lis-marcel/FoxSky.TractorVCU/doc/TractorVCU_v1.0_BOM.xlsx

TractorVCU v1.0 – lista elementów (BOM)
Źródło: schematy Tractor2000.SchDoc, MCU.SchDoc, LOAD_SWITCHES.SchDoc, POWER.SchDoc (10.06.2026)
Liczba płytek do złożenia: |  |  | 1
Legenda: żółte pole – wpisz liczbę płytek; niebieskie liczby – ilości wpisane ręcznie (reszta liczona z listy oznaczeń); „TAK” w kolumnie Weryfikacja – obudowa przyjęta jako typowa, bo PDF schematu nie zawiera footprintów – sprawdź z PCB przed zamówieniem.
Lp. | Oznaczenia | Ilość / płytkę | Wartość | Opis | Obudowa | Producent / przykładowy MPN | Montaż | Weryfikacja | Uwagi | Do zamówienia
Półprzewodniki i moduły
1 | U1 | 1 | NodeMCU-32 (30-pin) | Moduł ESP32 devkit (ESP32-WROOM-32) | Moduł, raster 2,54 mm | NodeMCU-32 / ESP32 DevKit V1 30-pin | THT |  | Wkładany w gniazda z poz. poniżej, nie lutowany | 1
2 | U1 – gniazda | 2 | Gniazdo żeńskie 1×15 | Listwa żeńska prosta, raster 2,54 mm, wys. ok. 8,5 mm | THT 1×15 | dowolna listwa żeńska 1×15 2,54 mm | THT |  | 2 szt. na płytkę (rząd 1–15 i 16–30). Sprawdź rozstaw rzędów footprintu z devkitem (22,86 vs 25,4 mm) | 2
3 | U2 | 1 | TPS562201DDCR | Przetwornica buck 4,5–17 V / 2 A | SOT-23-6 (DDC) | Texas Instruments TPS562201DDCR | SMD |  |  | 1
4 | L1 | 1 | 3,3 µH | Dławik mocy | 1008 (2520 metric) | Taiyo Yuden MAMK2520T3R3M | SMD |  |  | 1
5 | Q1, Q2, Q3, Q7, Q8, Q9, Q13, Q14, Q15, Q19, Q20, Q21 | 12 | AO3401 | P-MOSFET −30 V (klucz high-side) | SOT-23 | Alpha & Omega AO3401A | SMD |  |  | 12
6 | Q4, Q5, Q6, Q10, Q11, Q12, Q16, Q17, Q18, Q22, Q23, Q24, Q25 | 13 | BSS138 | N-MOSFET 50 V (sterowanie bramek, klucz buzzera) | SOT-23 | onsemi BSS138 | SMD |  |  | 13
7 | CR1 | 1 | SMBJ7.0A | Dioda TVS jednokierunkowa 7,0 V / 600 W | SMB (DO-214AA) | Littelfuse SMBJ7.0A lub odp. | SMD |  | Katoda na V_ESC | 1
8 | D1 | 1 | SS14 | Dioda Schottky 1 A / 40 V | SMA (DO-214AC) | SS14 (np. onsemi, Vishay) | SMD |  | Anoda V_ESC, katoda V_BUCK | 1
9 | D2 | 1 | 1N4148WT | Dioda impulsowa (zwrotna buzzera) | SOD-523 | 1N4148WT (np. Diodes Inc.) | SMD | TAK | Na wcześniejszych widokach PCB footprint D2 był większy niż SOD-523 – ujednolić element i footprint | 1
10 | D3, D4 | 2 | LED | Dioda LED sygnalizacyjna (kolor dowolny) | 0603 | dowolna LED 0603 | SMD |  | Debug LED, z R40/R41 330 Ω | 2
Kondensatory
11 | C3, C4 | 2 | 220 µF / 16 V | Kondensator polimerowy SMD (bulk V_ESC) | Ø6,3 mm lub wg footprintu | PCJ1C221MCL4GS | SMD | TAK | Dobrać MPN do średnicy footprintu na PCB | 2
12 | C13 | 1 | 47 µF / 16 V | MLCC X5R/X7R (hold-up V_BUCK) | 1210 | dowolny 47 µF 16 V X5R 1210 | SMD |  |  | 1
 | C5 | 1 | 10 µF / 16 V | MLCC X5R/X7R | 0603 | dowolny 10 µF 16–25 V X7R 1206 | SMD | TAK | C9–C12 przy grupach złączy, C5 wejście bucka | 1
13 | C9, C10, C11, C12 | 4 | 10 µF / 16 V | MLCC X5R/X7R | 0805 | dowolny 10 µF 16–25 V X7R 0805 | SMD | TAK | C9–C12 przy grupach złączy, C5 wejście bucka | 4
14 | C7, C8 | 2 | 22 µF / 10 V | MLCC X5R/X7R (wyjście bucka) | 0603 | dowolny 22 µF 10 V X5R 0603 | SMD | TAK |  | 2
15 | C14 | 1 | 1 µF / 16 V | MLCC X7R (zasilanie buzzera) | 0603 | dowolny 1 µF 16 V X7R 0603 | SMD | TAK |  | 1
16 | C1, C2, C6 | 3 | 100 nF / 50 V | MLCC X7R | 0402 | dowolny 100 nF 50 V X7R 0603 | SMD | TAK | C2 – bootstrap bucka (VBST–SW) | 3
Rezystory (1%)
17 | R1 | 1 | 1 kΩ | Rezystor szeregowy ESC_CONTROL | 0402 | dowolny 1 kΩ 1% 0603 | SMD | TAK |  | 1
18 | R3, R4, R5, R11, R12, R13, R19, R20, R21, R28, R29, R30 | 12 | 2,2 kΩ | Pull-up bramek AO3401 | 0402 | dowolny 2,2 kΩ 1% 0603 | SMD | TAK |  | 12
19 | R2, R6, R7, R8, R9, R10, R14, R15, R16, R17, R18, R22, R23, R24, R25, R26, R27, R31, R32, R33, R34, R35, R36, R38, R39 | 25 | 10 kΩ | Pull-downy bramek i wyjść, pull-down ESC, dzielnik FB | 0402 | dowolny 10 kΩ 1% 0603 | SMD | TAK | R38 – dolny rezystor dzielnika FB bucka | 25
20 | R37 | 1 | 33 kΩ | Górny rezystor dzielnika FB bucka | 0402 | dowolny 33 kΩ 1% 0603 | SMD | TAK | Vout = 0,768 V × (1 + 33k/10k) ≈ 3,30 V | 1
21 | R40, R41 | 2 | 330 Ω | Rezystory LED debug | 0603 | dowolny 330 Ω 1% 0603 | SMD | TAK |  | 2
Złącza
22 | J1, J2, J3, J4, J5, J6, J7, J8, J9, J10, J11, J12, J13 | 13 | HTSW-103-24-T-S | Listwa męska prosta 1×3, raster 2,54 mm | THT 1×3 | Samtec HTSW-103-24-T-S | THT |  | Alternatywnie zwykły goldpin 1×3 (lub listwa 1×40 cięta) | 13
23 | J14 | 1 | Goldpin 1×2 | Listwa męska prosta 1×2, raster 2,54 mm (buzzer) | THT 1×2 | dowolny goldpin 1×2 2,54 mm | THT |  |  | 1
Elementy PCB (nie zamawiane osobno)
24 | TP1, TP2, TP3, TP4, TP5, TP6 | 6 | Punkt testowy | Pad testowy | — | — | PCB | TAK | Jeśli footprint to pętla THT (np. Keystone 5012) – dopisz do zamówienia | —
25 | MH1, MH2, MH3, MH4 | 4 | Otwór M3 | Otwór montażowy metalizowany (GND) | — | — | PCB |  | Śruby/dystanse M3 – wg mocowania w modelu | —
Poza płytką (opcjonalnie)
26 | — | 1 | LD-BZEG-1203 | Buzzer elektromagnetyczny z generatorem 2–5 V, 30 mA | THT Ø12 mm | Loudity LD-BZEG-1203 | Poza płytką |  | Na kablu do J14, zachować polaryzację | 1
27 | — | 1 | Przewód z wtykiem 1×2 | Przewód z gniazdem żeńskim 2,54 mm do J14 | — | np. przewód Dupont F 1×2 | Poza płytką |  |  | 1
Podsumowanie (na 1 płytkę)
 | Elementy SMD | 87
 | Elementy THT (z gniazdami devkita) | 17
 | Razem do montażu na płytce | 104
