lis-marcel/FoxSky.TractorVCU/doc/FoxSky.TractorVCU.pdf

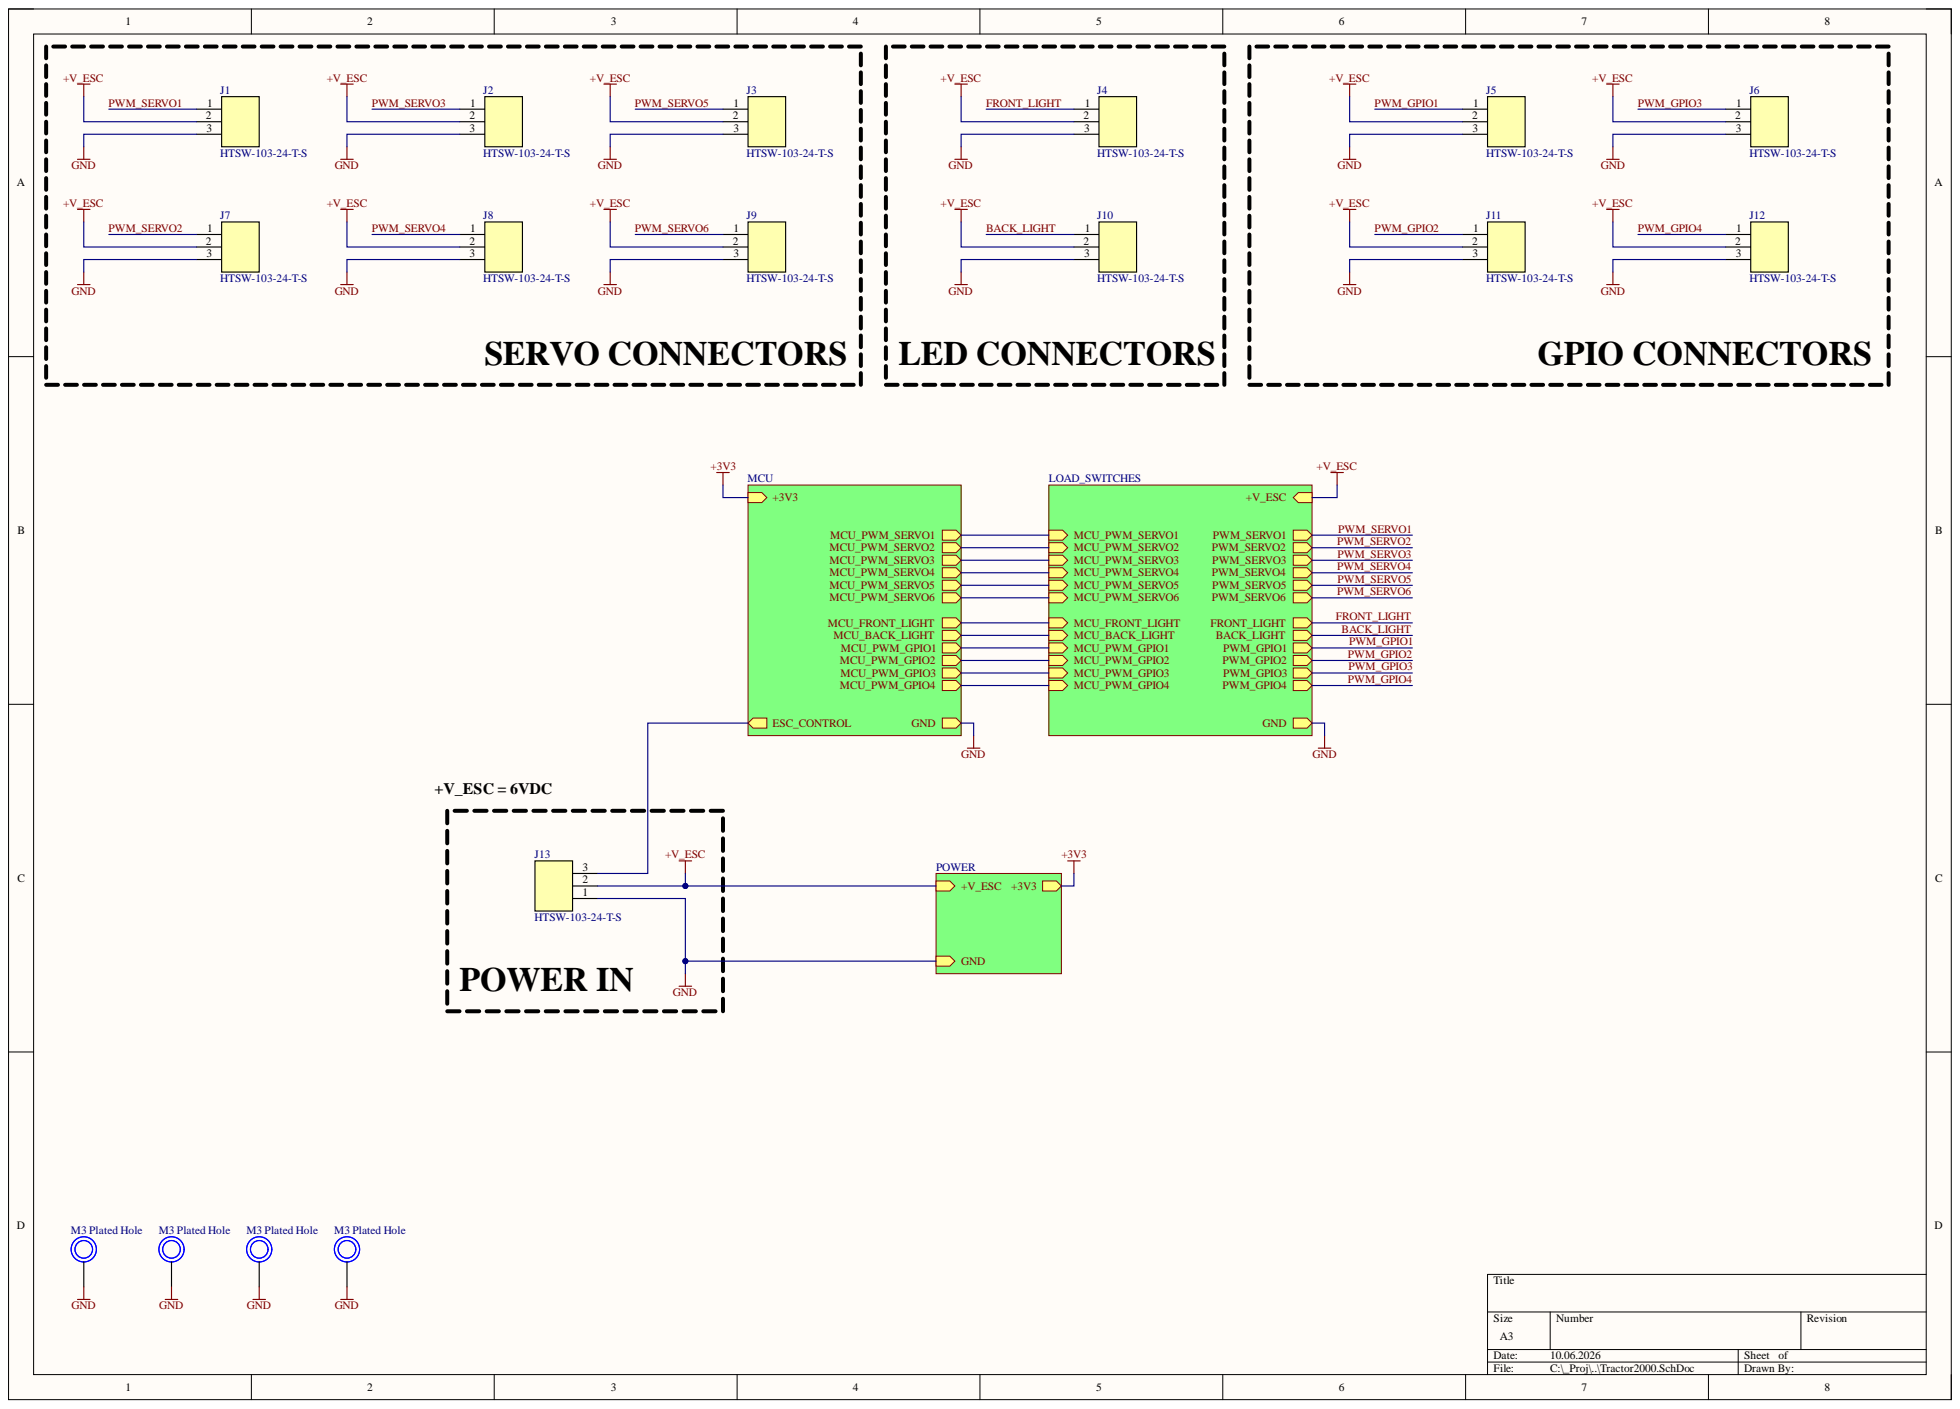
[picture p1: page 1]

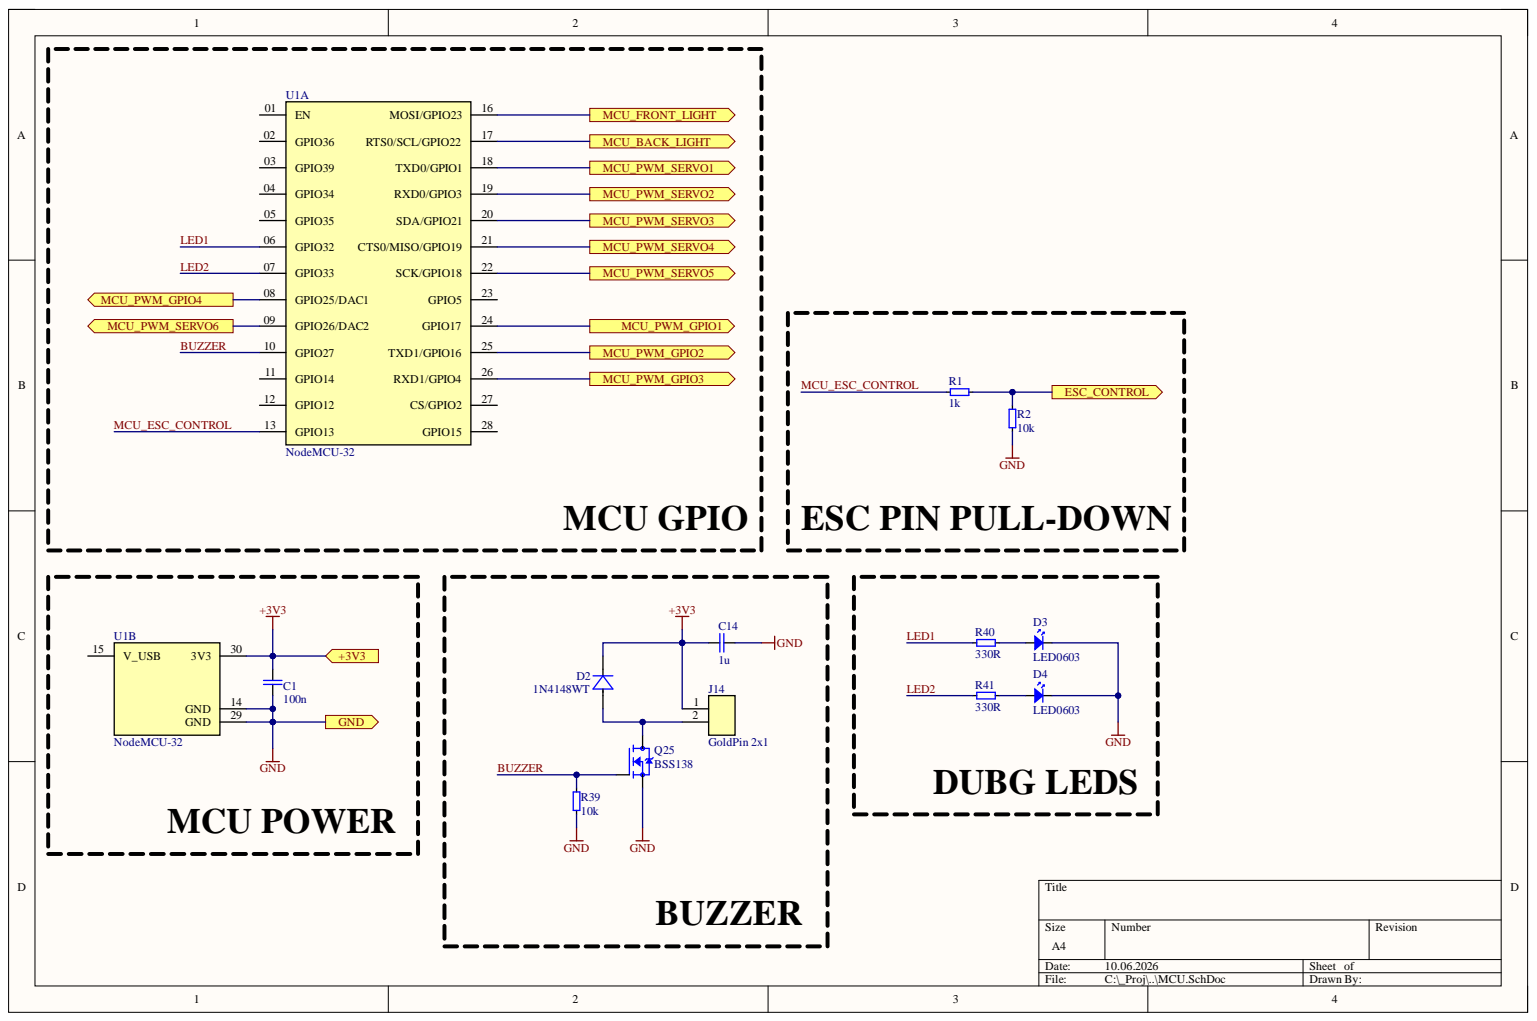
[picture p2: page 2]

ESC PIN PULL-DOWN

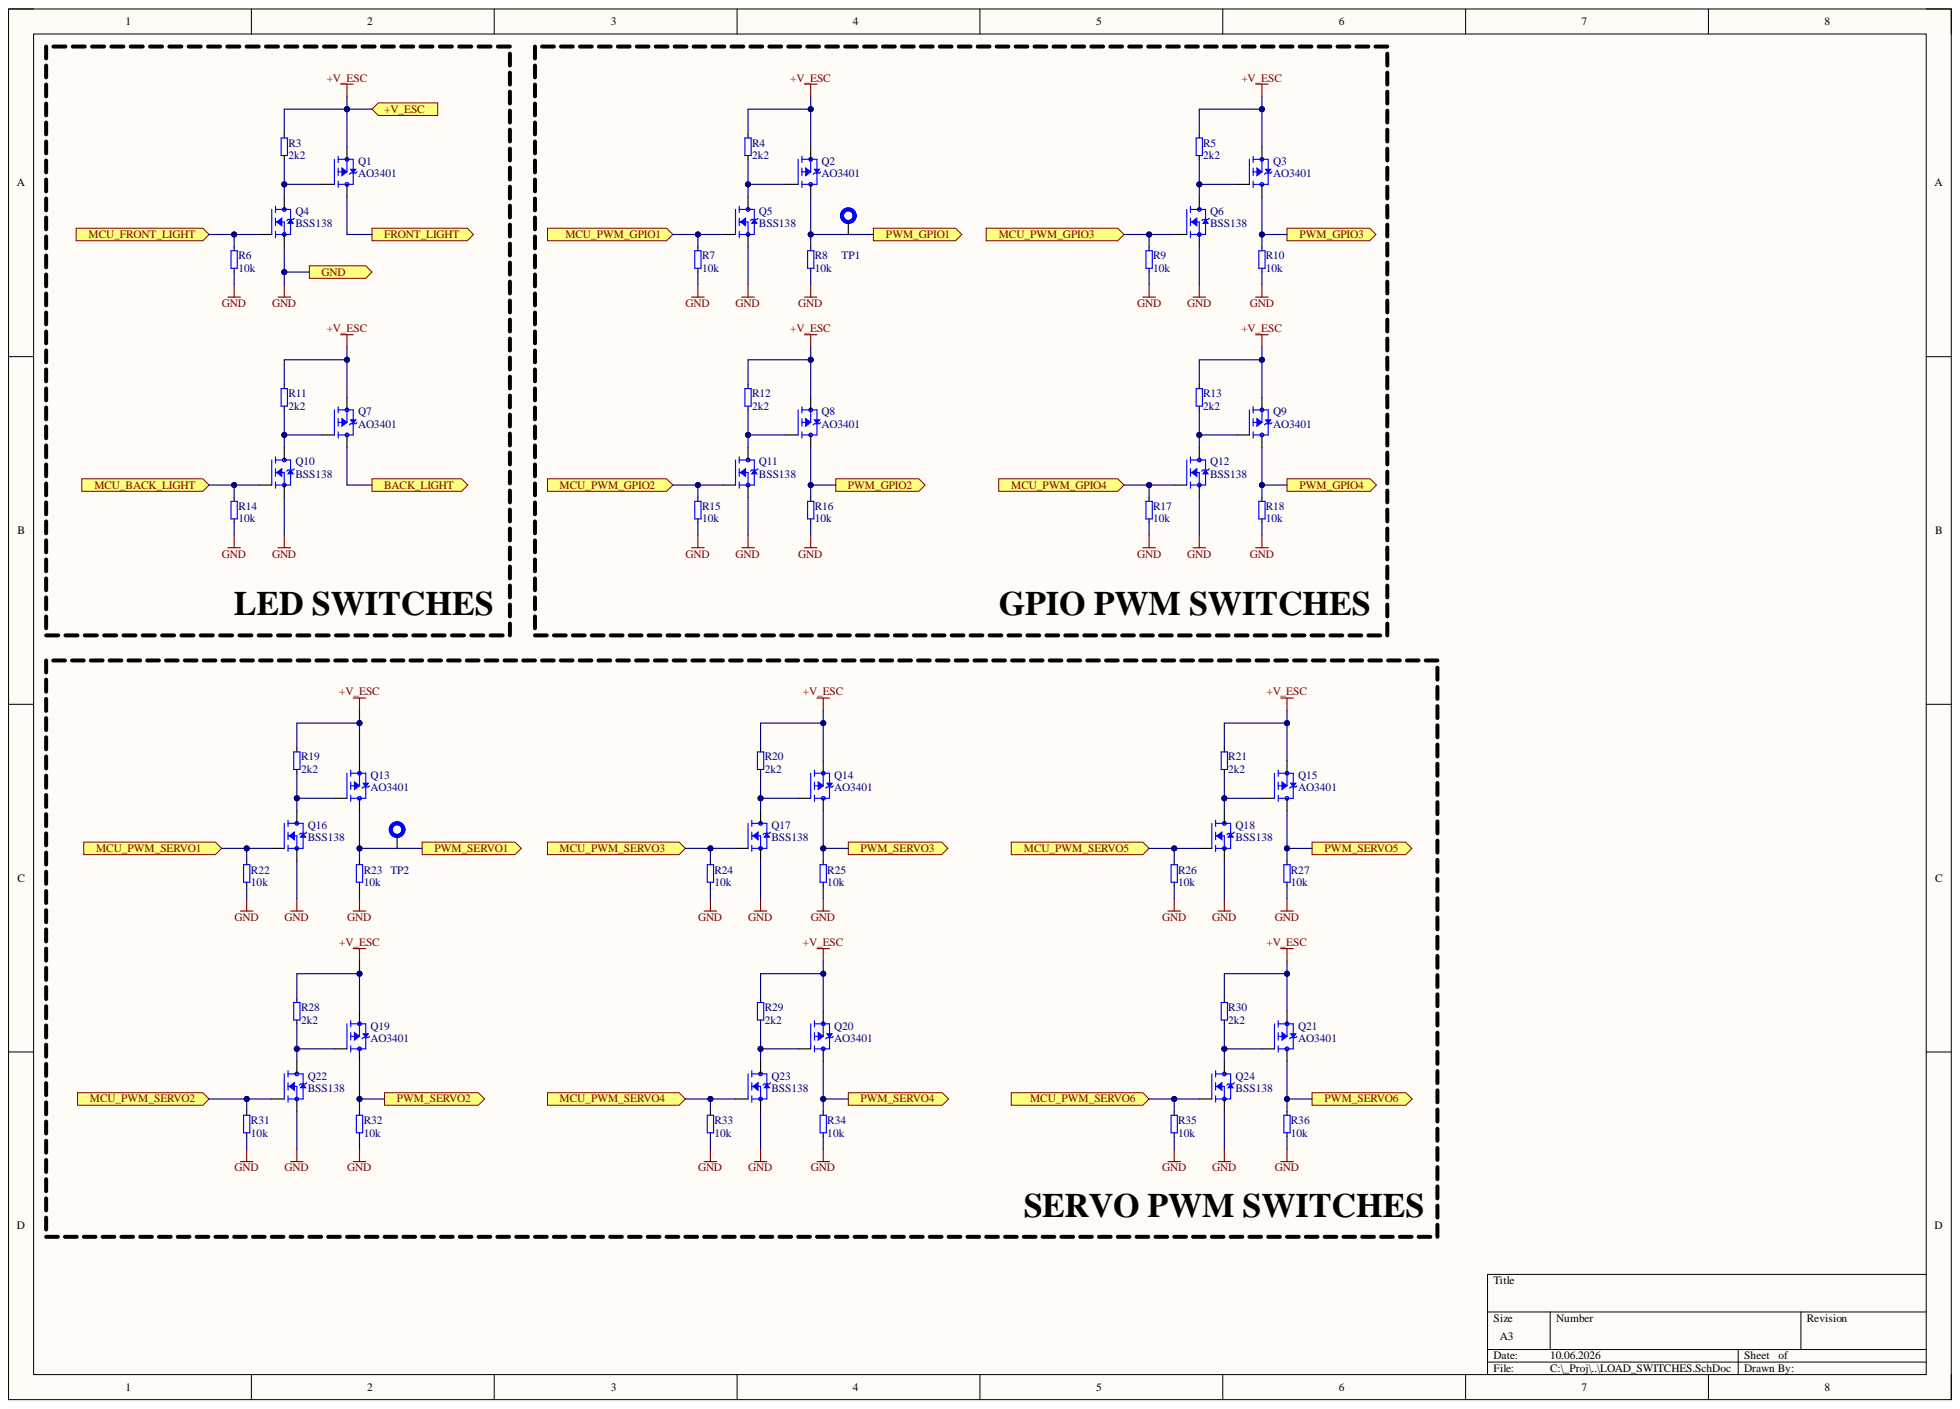
[picture p3: page 3]

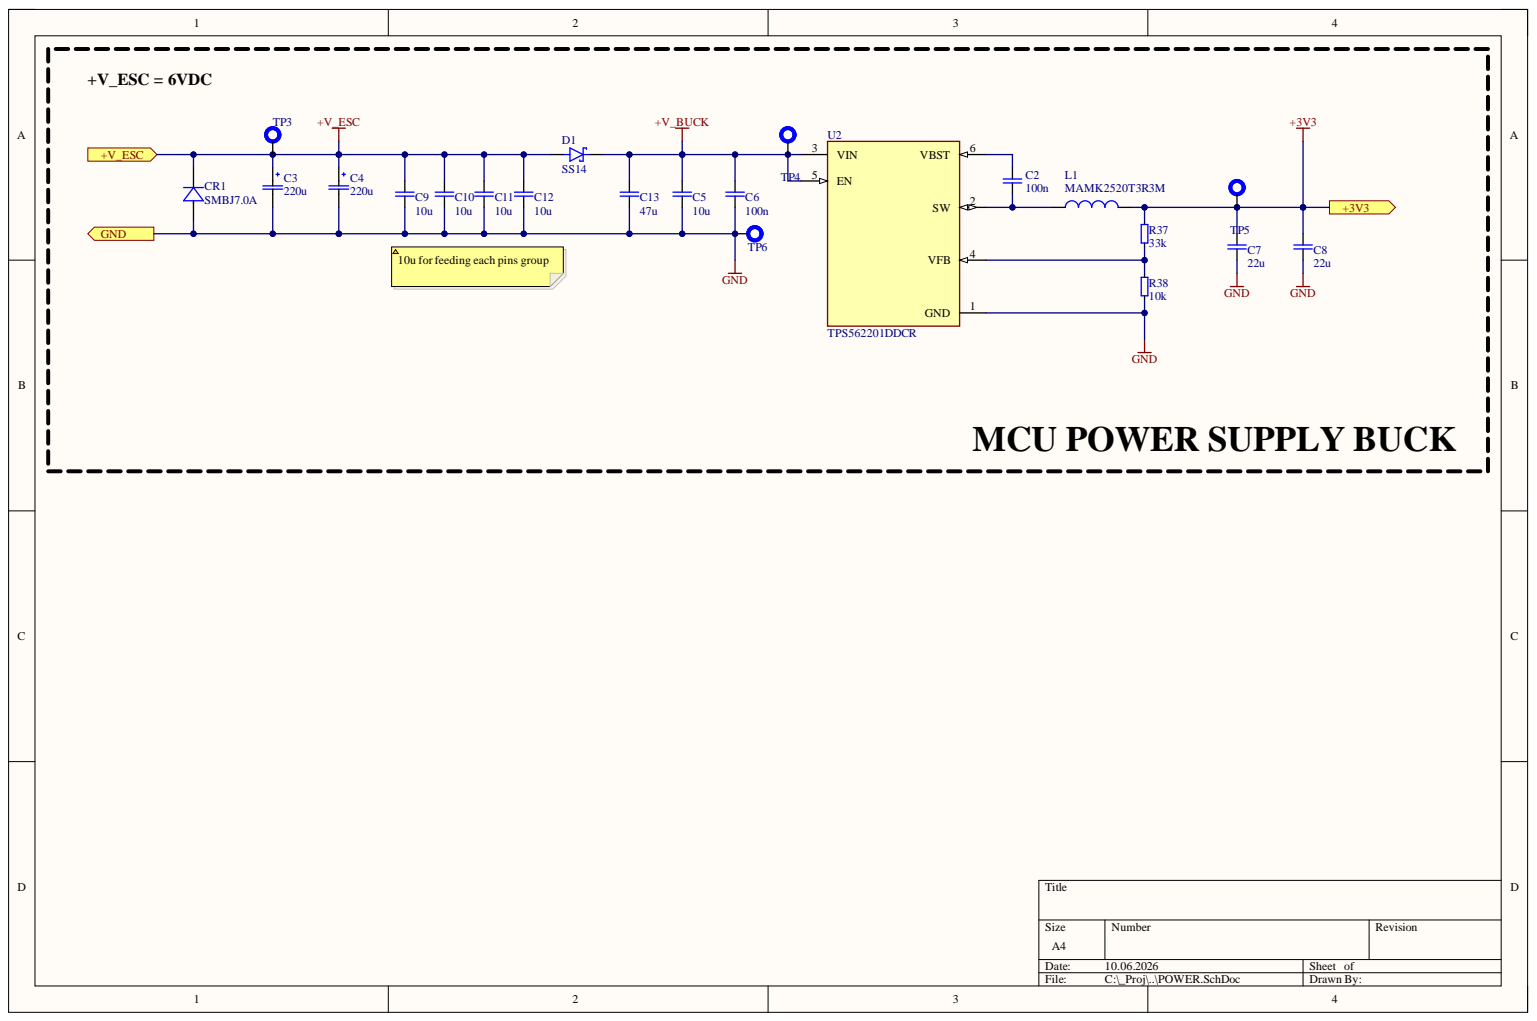
[picture p4: page 4]

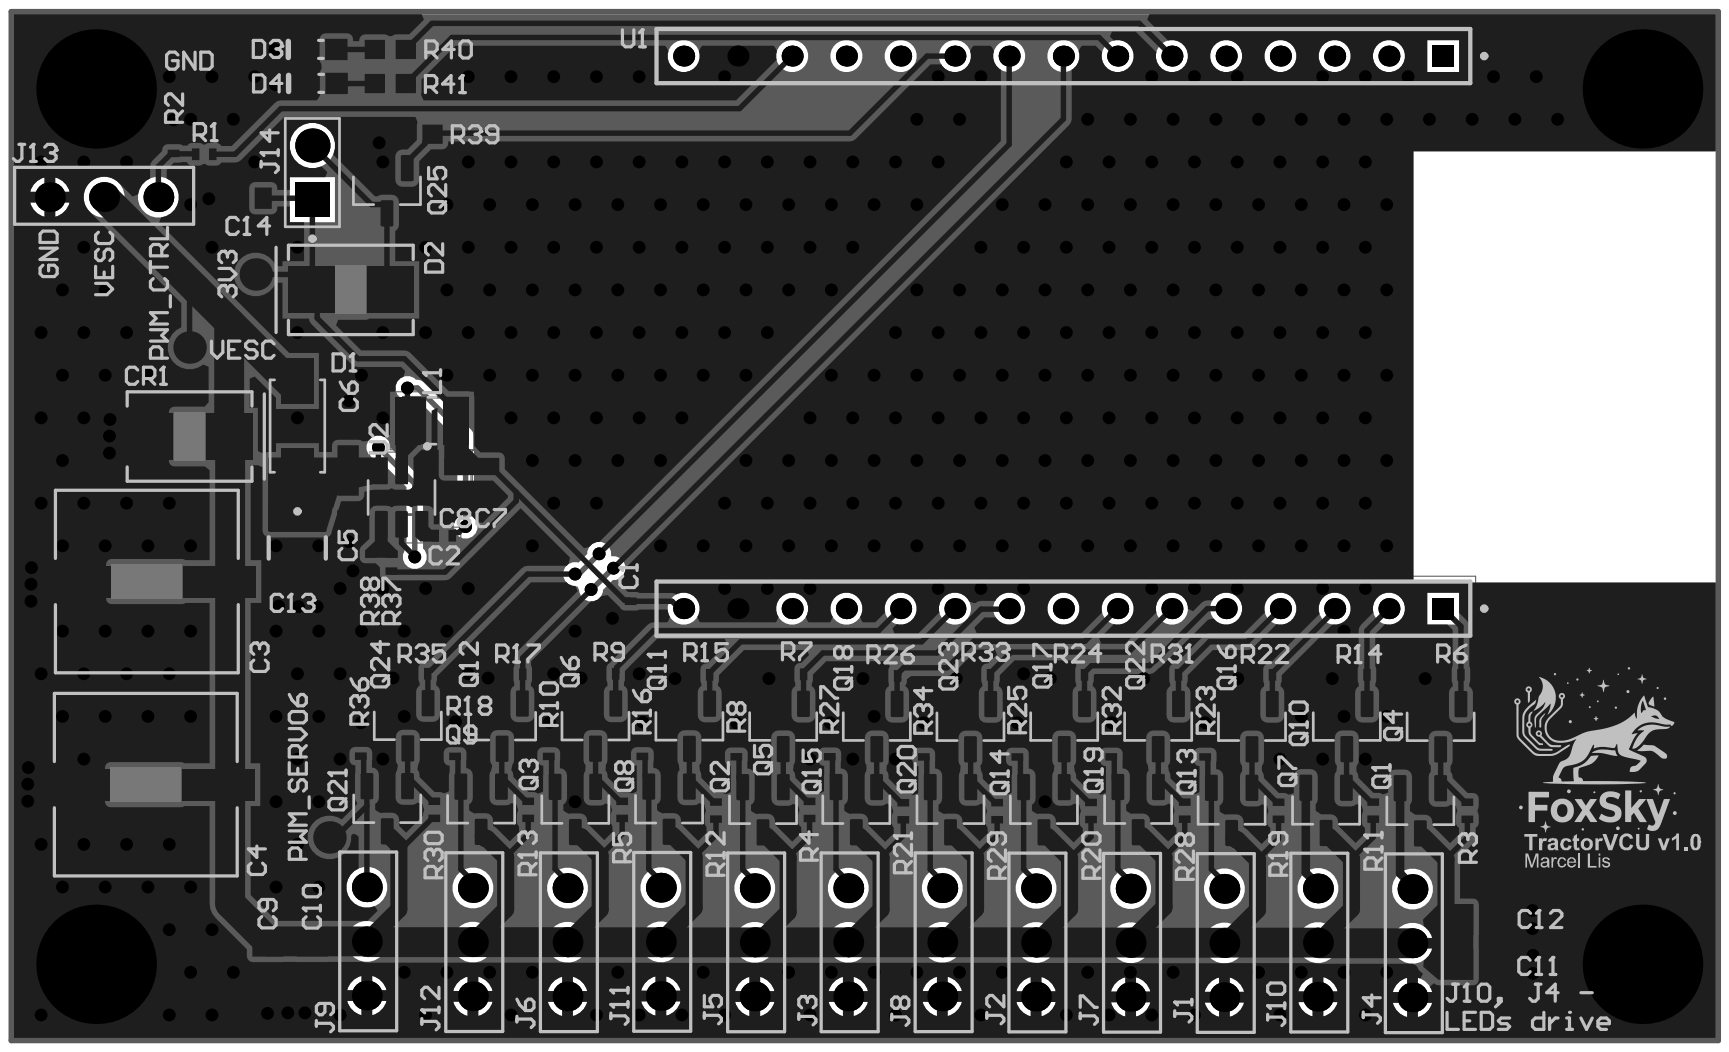
[picture p5: page 5]
