lis-marcel/FoxSky.TractorVCU/(list of files, drawings)

Other design files:
src/pcb/FoxSky.Tractor2000/FoxSky.Tractor2000.PrjPcb
src/pcb/FoxSky.Tractor2000/FoxSky.TractorVCU.PcbDoc
src/pcb/FoxSky.Tractor2000/LOAD_SWITCHES.SchDoc
src/pcb/FoxSky.Tractor2000/MCU.SchDoc
src/pcb/FoxSky.Tractor2000/Tractor2000.PcbLib
