lis-marcel/FoxSky.TractorVCU/(commit log)

2026-10-04 [feat] started routing
    [FoxSky.Tractor2000.PrjPcb, FoxSky.TractorVCU.PcbDoc, MCU.SchDoc, Tractor2000.PcbLib]
2026-10-06 [feat] finished placing and routing
    [FoxSky.TractorVCU.PcbDoc, MCU.SchDoc, Tractor2000.PcbLib]
2026-10-06 [fix] fixed gnd via stiching
    [FoxSky.TractorVCU.PcbDoc]
2026-10-06 [fix] fixed silkscreen descriptions
    [FoxSky.TractorVCU.PcbDoc, LOAD_SWITCHES.SchDoc, Tractor2000.PcbLib, TractorVCU_v1.0_BOM.xlsx]
2026-10-06 [fix] fixed silkscreen description for buzzer
    [FoxSky.TractorVCU.PcbDoc]
2026-10-07 [fix] added missing descriptions for power ports
    [FoxSky.TractorVCU.PcbDoc]
2026-10-09 [fix] fixed power paths width and polygon connections
    [FoxSky.TractorVCU.PcbDoc]
2026-10-09 [fix] added missing route for buck en
    [FoxSky.TractorVCU.PcbDoc]
2026-10-09 [fix] fixed vias positions
    [FoxSky.TractorVCU.PcbDoc]
